vkalipat/lancet-cartridge/(list of files, cad)

Other CAD files:
cad/tube_cap.stl
cad/tube_body.stl
cad/tube_assembly.f3d
