vkalipat/lancet-cartridge/(commit log)

2026-05-02 Initial release: LANCET cartridge open-source design files
    Includes: 3D printable tube CAD (placeholders pending real exports), Arduino
    firmware (5-phase thermal protocol, DS18B20 closed-loop feedback, 60 deg C
    safety cutoff), bill of materials (USD 48.58 durable + ~USD 1.20 single-use),
    build and validation protocols, license texts (CERN-OHL-W v2, MIT, CC BY 4.0),
    Zenodo metadata, citation file.
    Companion HardwareX manuscript in preparation.
    [bom.csv, heater_pcb.kicad_pcb, heater_schematic.sch, thermal_protocol_set_points.csv, tube_assembly.f3d, tube_body.stl, tube_cap.stl]
2026-05-09 Wire real Zenodo DOIs after v0.1.1 release minted
    Concept DOI (always-latest): 10.5281/zenodo.20101160
    Version DOI (v0.1.1): 10.5281/zenodo.20101161
    Also drop "Lambert iGEM 2025 Team" from the README citation block to match
    CITATION.cff and .zenodo.json (hardware authors only: Gulati, Kalipatnapu, Karthik).
    HardwareX DOI placeholder stays "10.0000/PLACEHOLDER (in prep)" until the
    paper is accepted.
